CreativeLau/Mini-DSO/pic/IMG_6265.JPG

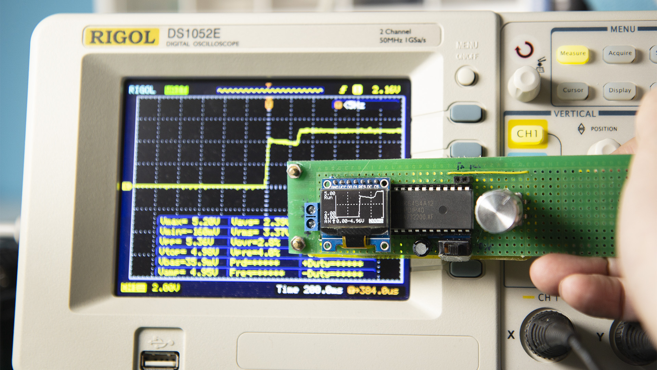
pic/IMG_6265.JPG
