CreativeLau/Mini-DSO/pic/IMG_6266.JPG

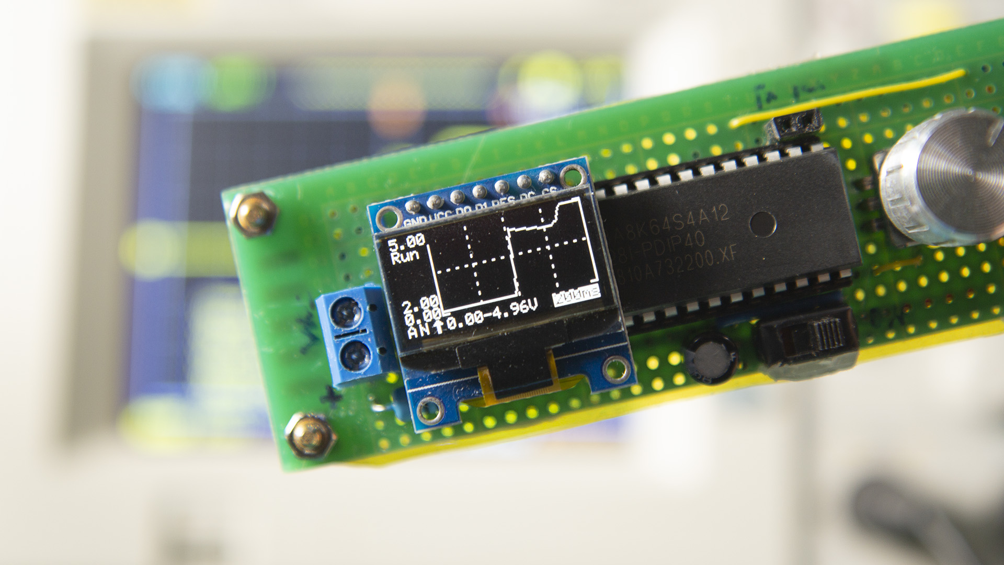
pic/IMG_6266.JPG
