CreativeLau/Mini-DSO/pic/IMG_6268.JPG

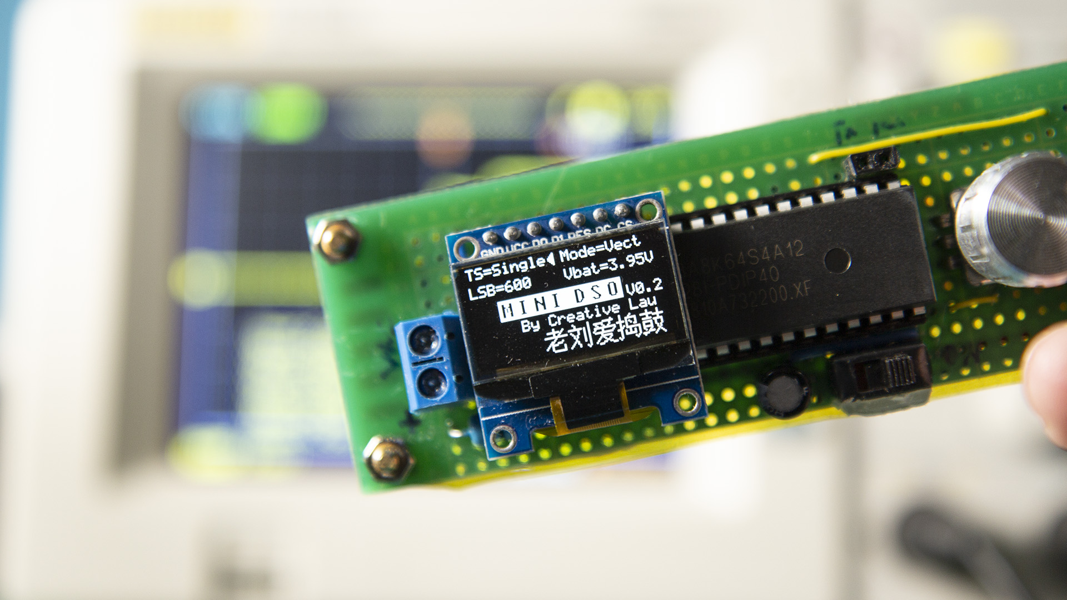
pic/IMG_6268.JPG
