CreativeLau/Mini-DSO/pic/IMG_6270.JPG

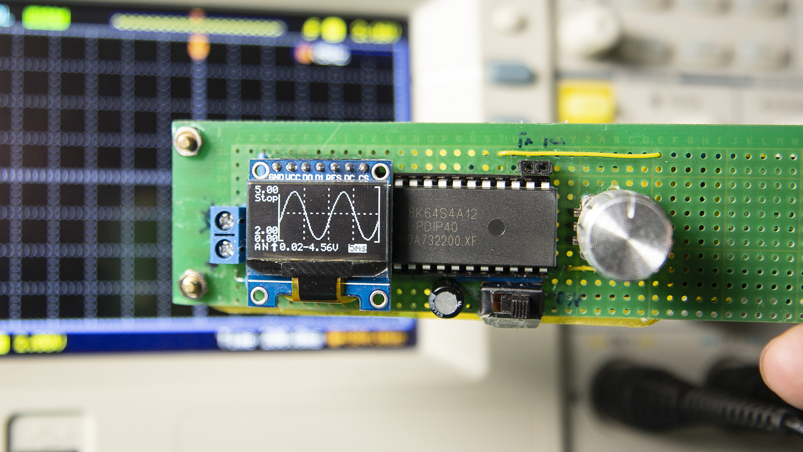
pic/IMG_6270.JPG
