CreativeLau/Mini-DSO/(threads)

Thread 1 (2020-05-19):

关于输入采样电路的疑问

jamwu, 2020-05-19:
老刘你好，我发现你设计的电路中，输入采样电路采用10k串上2k的电阻进行分压的。对此，我有点疑问，如下图：
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

CreativeLau, 2020-05-19:
单片机的ADC输入阻抗比较低，如果外部的分压输入阻抗太高的话会影响ADC的采样结果。你的这个电路，加上DSO后，R8和R9+R10等于是并联到一起，并联后的值是6K，6K和R7串在一起分压刚好是1/3。输入阻抗低的问题可以通过增加运放解决，但一般的运放在转换高频信号时速度跟不上。

jamwu, 2020-05-19:
> 单片机的ADC输入阻抗比较低，如果外部的分压输入阻抗太高的话会影响ADC的采样结果。你的这个电路，加上DSO后，R8和R9+R10等于是并联到一起，并联后的值是6K，6K和R7串在一起分压刚好是1/3。输入阻抗低的问题可以通过增加运放解决，但一般的运放在转换高频信号时速度跟不上。

懂了，我是没考虑到mcu的adc内部阻抗。那就是说按照目前的设计，只能用来测量等效电阻较小(<1k)的电路。否则误差就会比较大了是吧。另外，我觉得你这个挺有意思的，就按照你提供的资料，我自己也画 了个小板。不过还没焊接测试，下面附上3d图。测试没问题的话，会在这里提供项目的链接。
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

jamwu, 2020-05-27:
@CreativeLau 这里分享一下工程的链接-[Mini-DSO-PCB](https://oshwhub.com/jam_dan/mini_dso)

Thread 2 (2022-04-16):

限制这个示波器采样频率的瓶颈在哪里？

jamesbondjava, 2022-04-16:
小白一个，想请教一下，限制这个示波器采样频率不能过高的原因都有哪些？

ybhhdt, 2022-04-16:
您好，您的信息我已收到

ybhhdt, 2022-04-16:
主要是时钟频率吧，频率上限在哪里，而且处理数据也需要性能吧，了解得不太深入。

---原始邮件---
发件人: ***@***.***&gt;
发送时间: 2022年4月16日(周六) 下午5:16
收件人: ***@***.***&gt;;
抄送: ***@***.***&gt;;
主题: [CreativeLau/Mini-DSO] 限制这个示波器采样频率的瓶颈在哪里？ (Issue #2)

小白一个，想请教一下，限制这个示波器采样频率不能过高的原因都有哪些？

—
Reply to this email directly, view it on GitHub, or unsubscribe.
You are receiving this because you are subscribed to this thread.Message ID: ***@***.***&gt;

jamesbondjava, 2022-04-17:
@ybhhdt 非常感谢。那是否是：如果CPU的时钟频率、ADC的采样频率足够高，就可以了，对吗？

ddwtd, 2022-08-18:
不知道这个芯片能不能想stm32那样，用两个adc交叉采样一个通道来提高采样率

ybhhdt, 2022-08-18:
您好，您的信息我已收到

Thread 3 (2022-06-20):

一些计算细节的原理疑问？

HangX-Ma, 2022-06-20:
老刘你好，我在学习您的示波器代码的时候对以下几个计算公式感到了一些困惑，它们没有数学公式的说明，难以理解这样处理的缘由，希望您能给予解答。
- 问题1：在chart.c的AnalyseData()函数中，处理当前选择Option_MeaWay_AC方式进行测量的处理中，对DC输入您是用`Mvoltage_Aver += (VMax_m + VMin_m) >> 1`进行处理，但是AC部分却做了如下复杂计算，这个计算的依据是什么？
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

- 问题2：回头再看`VMax_m `和`VMin_m`，它们同样经过了一些处理，除此之外，它们是通过`adcMax-BiasVoltage`以及`adcMin-BiasVoltage`转换得到，`BiasVoltage`默认值为`8900`我原来猜测是4092满量程的偏移，但这个值还是让我感到困惑。
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

- 问题3：关于频率计算方面，您给了一个 $Waveform_{freq}=25000(ms)/(Range \times Interval)$ or $25000000(us)/(Range\times Interval)$ 的公式，`25000 or 25000000`这个基准值为什么这么选取？是与缓存大小相关吗？
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
```c
    switch (ScaleH)
    {
    case 0:                                      //500ms
        WaveFreq = 50.0f / (float)WaveLength + 0.5; //WaveFreq=25000/(500*WaveLength);
        break;

    case 1:                          //200ms
        WaveFreq = (125.0f / (float)WaveLength); //WaveFreq=25000/(200*WaveLength);
        break;

    case 2:                          //100ms
        WaveFreq = (250.0f / (float)WaveLength); //WaveFreq=25000/(100*WaveLength);
        break;

    case 3:                          //50ms
        WaveFreq = (500.0f / (float)WaveLength); //WaveFreq=25000/(50*WaveLength);
        break;

    case 4:                           //20ms
        WaveFreq = (1250.0f / (float)WaveLength); //WaveFreq=25000/(20*WaveLength);
        break;

    case 5:                           //10ms
        WaveFreq = (2500.0f / (float)WaveLength); //WaveFreq=25000/(10*WaveLength);
        break;

    case 6:                           //5ms
        WaveFreq = (5000.0f / (float)WaveLength); //WaveFreq=25000/(5*WaveLength);
        break;

    case 7:                            //2ms
        WaveFreq = (12500.0f / (float)WaveLength); //WaveFreq=25000/(2*WaveLength);
        break;

    case 8:                            //1ms
        WaveFreq = (25000.0f / (float)WaveLength); //WaveFreq=25000/(1*WaveLength);
        break;

    case 9:                            //500us
        WaveFreq = (50000.0f / (float)WaveLength); //WaveFreq=25000000/(500*WaveLength);
        break;

    case 10:                            //200us
        WaveFreq = (125000.0f / (float)WaveLength); //WaveFreq=25000000/(200*WaveLength);
        break;

    case 11:                            //100us
        WaveFreq = (250000.0f / (float)WaveLength); //WaveFreq=25000000/(100*WaveLength);
        break;
    }
```

- 问题4：在问题3中得到的$Waveform_{freq}$您又做了如下计算，这样做的目的以及依据是什么？
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
```c
WaveFreq = (float)WaveFreq /  (0.0162f * (log10(WaveFreq) /log10(2.7) ) + 0.9398f);
```
@CreativeLau 谢谢！

ybhhdt, 2022-06-20:
您好，您的信息我已收到
