CreativeLau/Mini-DSO/Ver.Frist/Mini DSO Scheme.pdf

# R3,R4用于电池电压采样，在关机状态下会消耗0.3mA左右的电流，如果介意则不要安装R3，R4

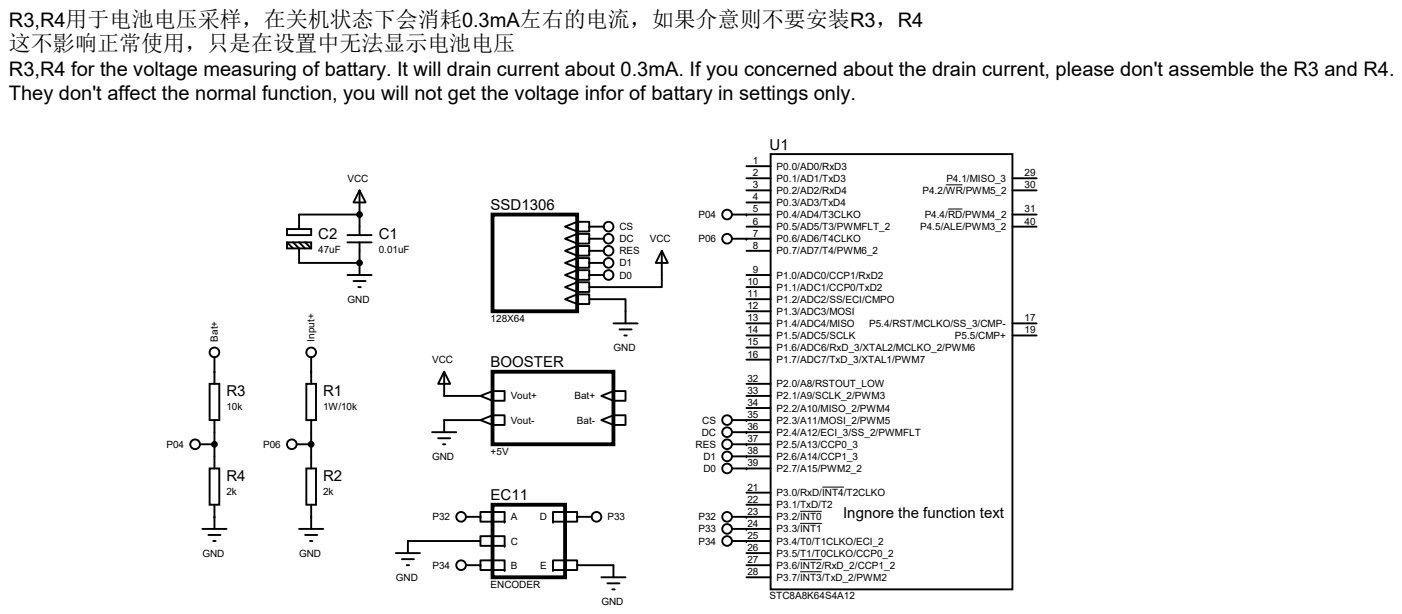
[picture p10: page 1]

这不影响正常使用，只是在设置中无法显示电池电压
R3,R4 for the voltage measuring of battary. It will drain current about 0.3mA. If you concerned about the drain current, please don't assemble the R3 and R4.
They don't affect the normal function, you will not get the voltage infor of battary in settings only.

Ingnore the function text
