CreativeLau/Mini-DSO/Ver.0.3/circuit_V0.3.pdf

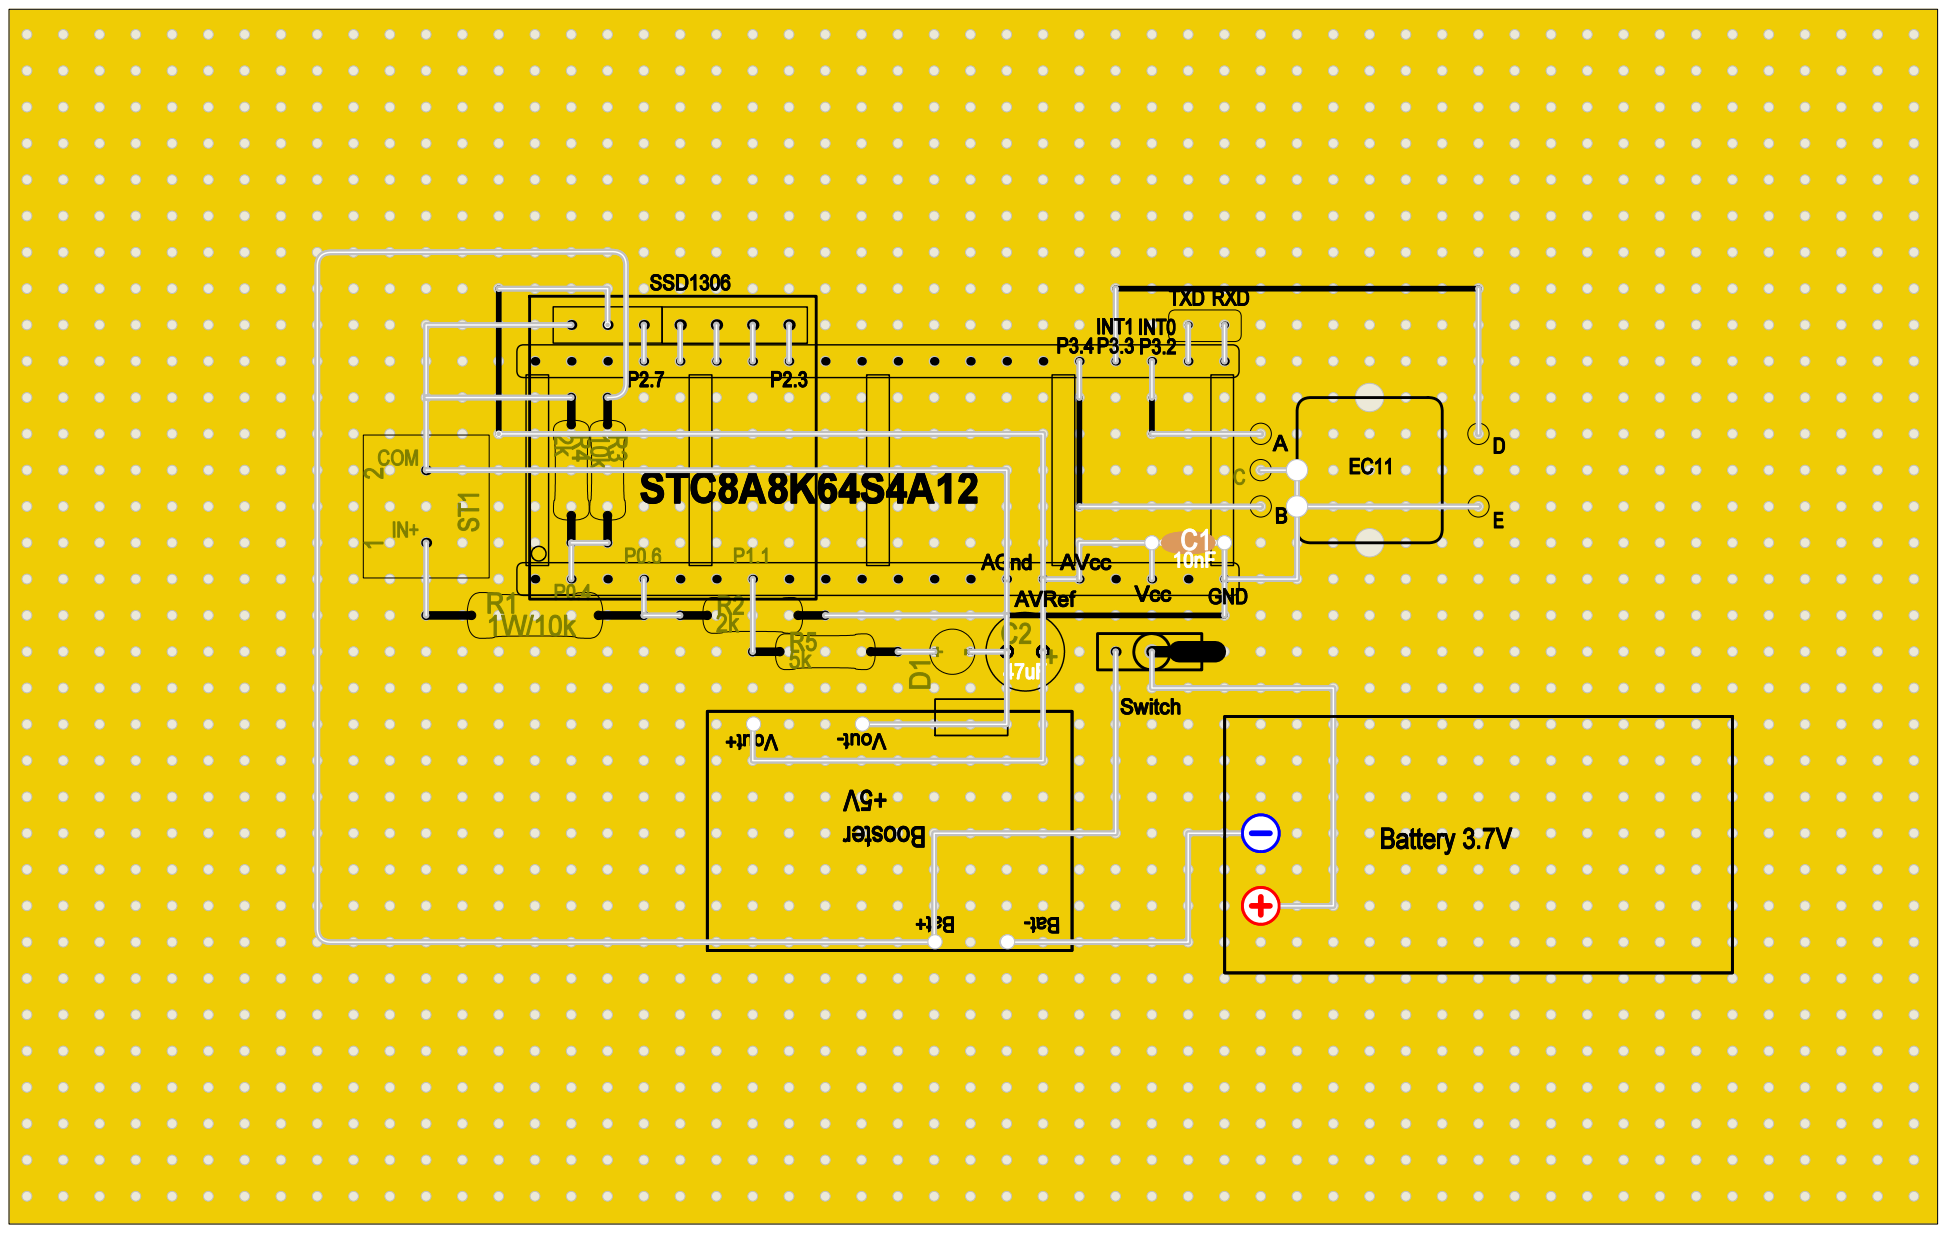
[picture p11: page 1]
