CreativeLau/Mini-DSO/Ver.0.3/Mini_DSO_Scheme_V0.3.pdf

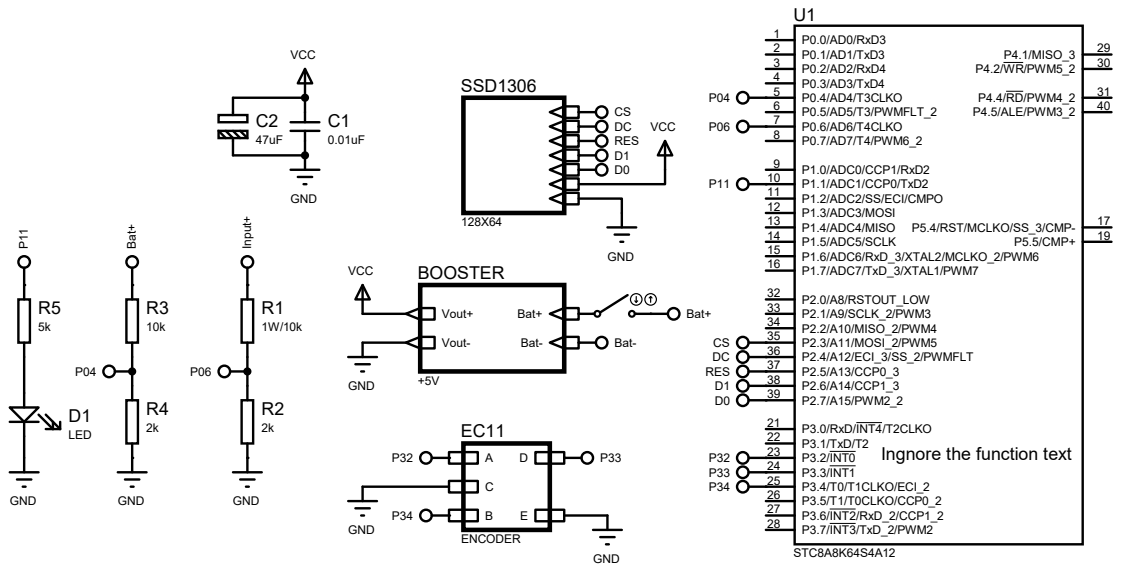
[picture p12: page 1]

Ingnore the function text
