CreativeLau/Mini-DSO/Ver.Frist/circuit1.pdf

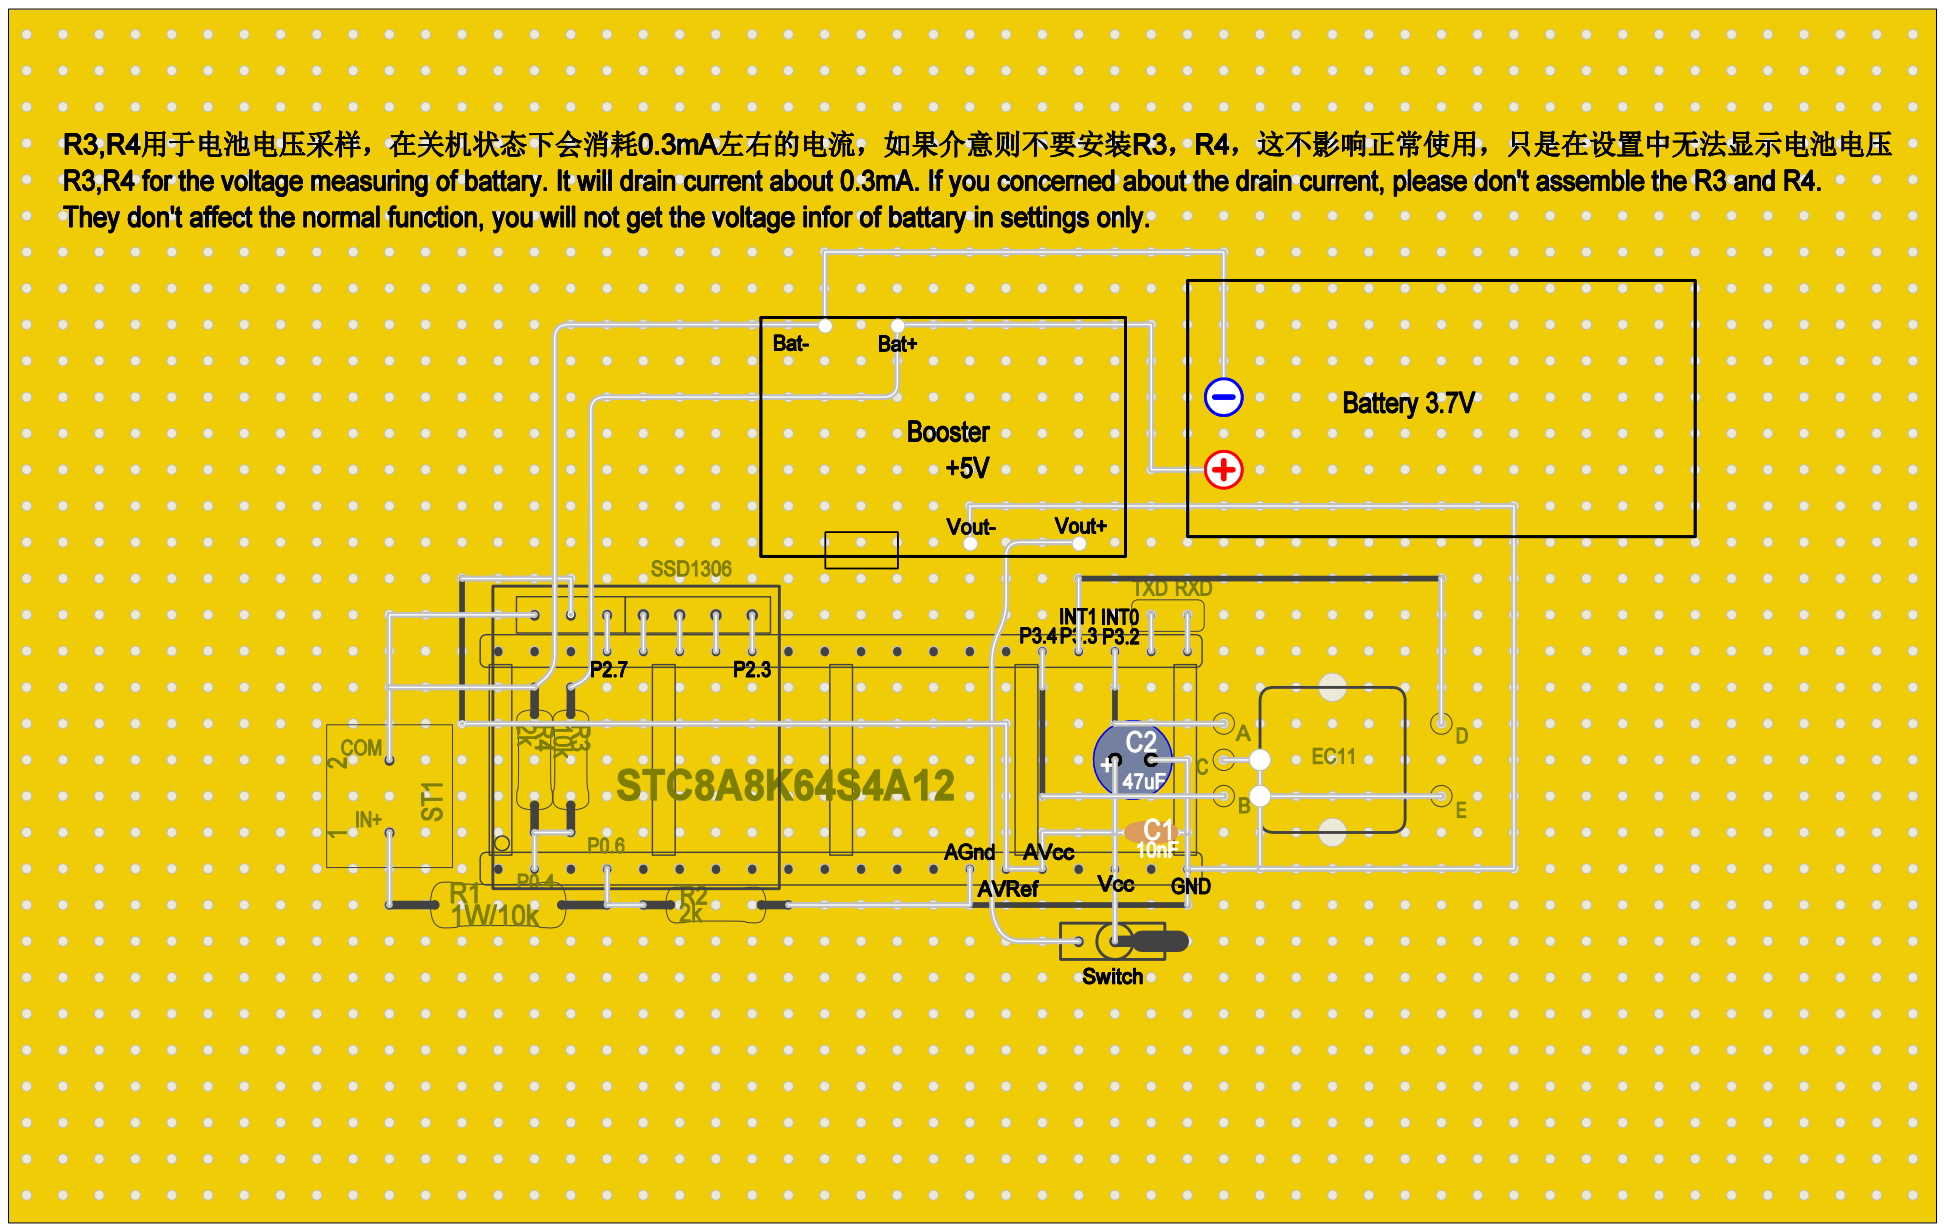
[picture p13: page 1]
