CreativeLau/Mini-DSO/Ver.Frist/circuit.pdf

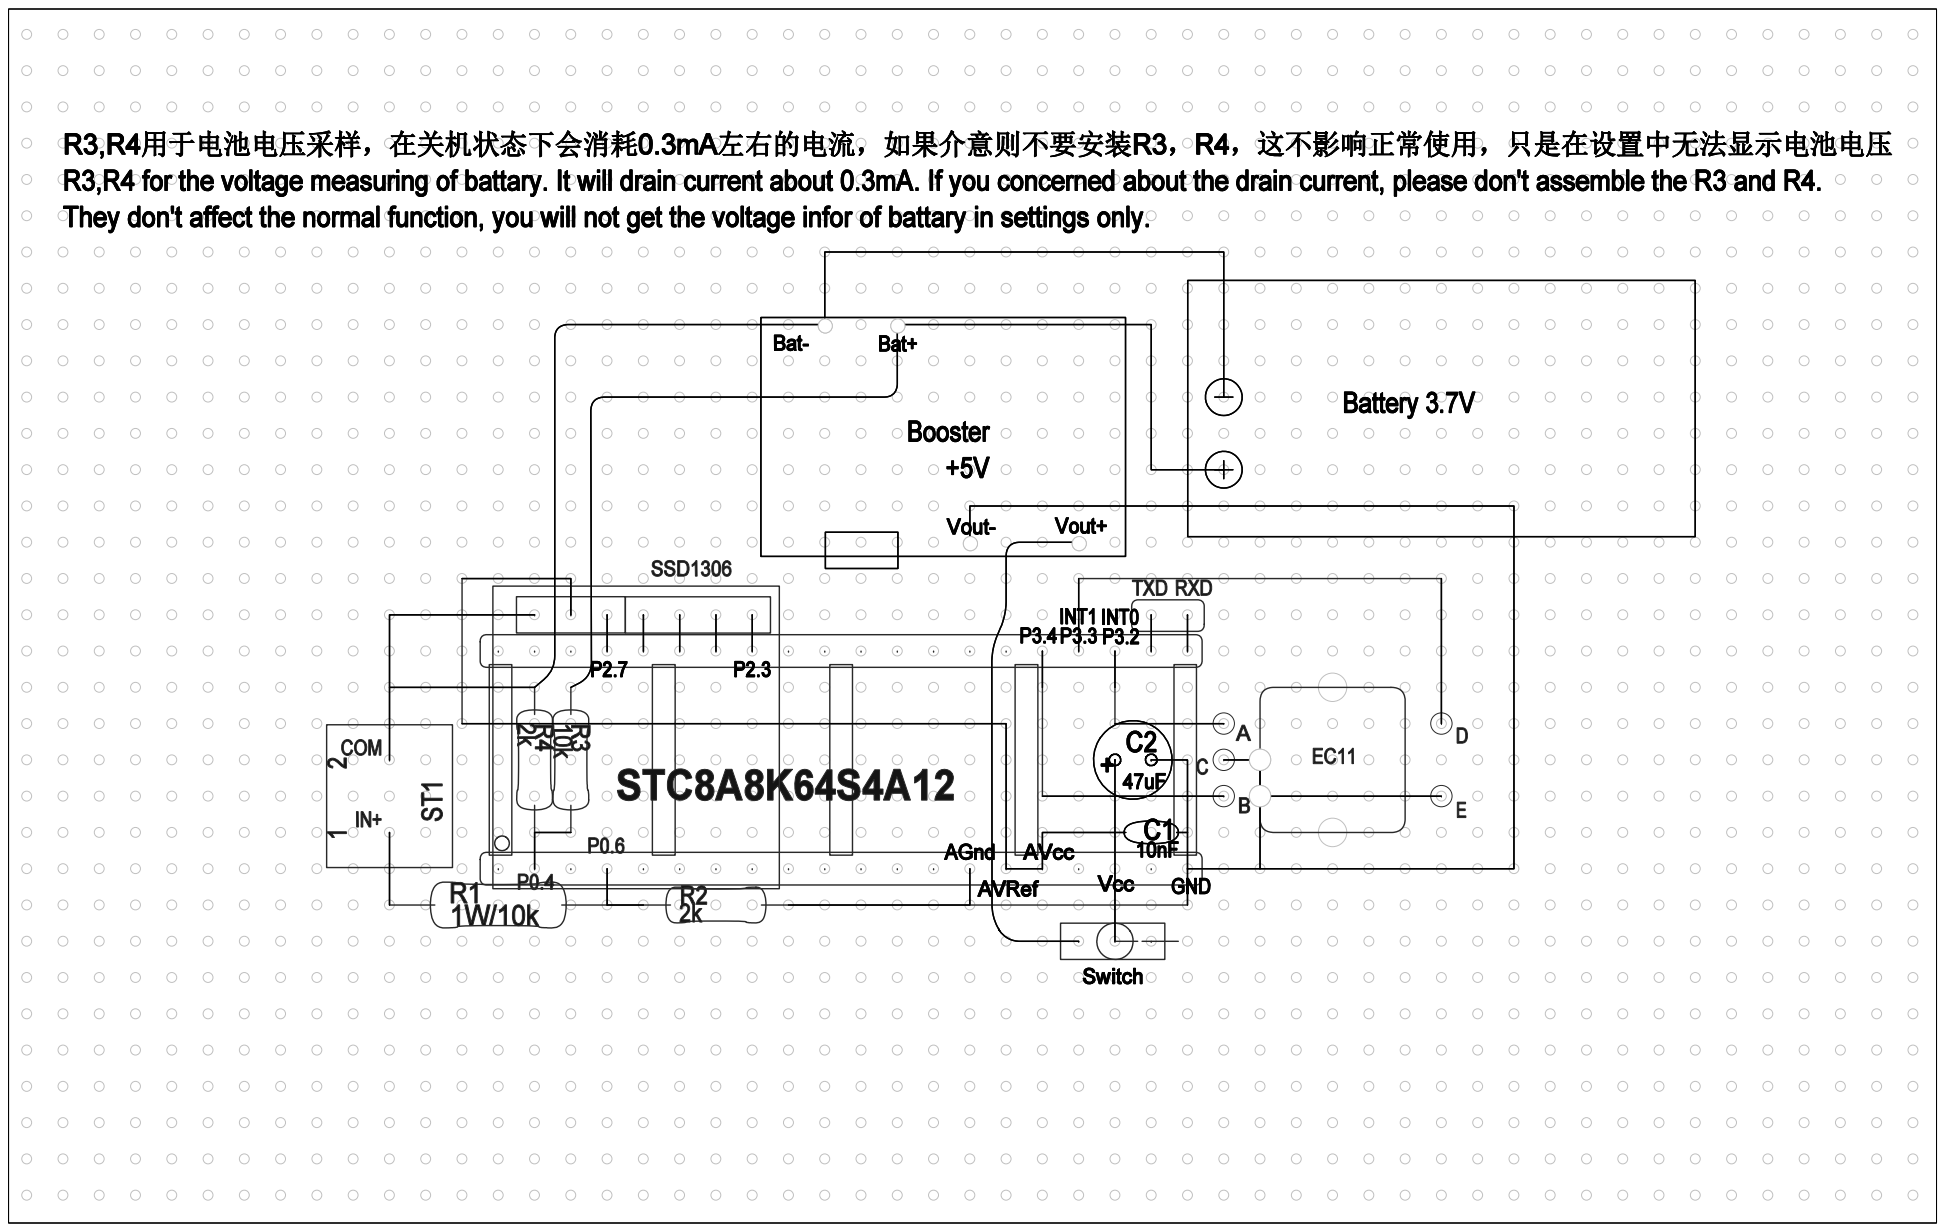
[picture p14: page 1]
