CreativeLau/Mini-DSO/(list of files, drawings)

Other design files:
Ver.0.3/Mini_DSO_Scheme_V0.3.pdsprj
Ver.Frist/Mini DSO Scheme.pdsprj
