CreativeLau/Mini-DSO/Ver.0.3/Code/bmp.h

#ifndef BMP_H
#define BMP_H

unsigned char code MINIDSO[]/*82x13*/ =
{
    0xFF, 0xFF, 0x03, 0x03, 0xEF, 0x1F, 0xEF, 0x03, 0x03, 0xFF, 0xFF, 0xFF, 0xFF, 0xFF, 0xFB, 0x03, 0x03, 0xFB, 0xFF, 0xFF, 0xFF, 0xFF, 0xFF, 0xFF, 0x03, 0x03, 0xCF, 0x9F, 0x3F, 0x03, 0x03, 0xFF, 0xFF, 0xFF, 0xFF, 0xFF, 0xFB, 0x03, 0x03, 0xFB, 0xFF,
    0xFF, 0xFF, 0xFF, 0xFF, 0xFF, 0xFF, 0xFF, 0xFF, 0xFF, 0xFF, 0x03, 0x03, 0xFB, 0xF3, 0x07, 0x0F, 0xFF, 0xFF, 0xFF, 0xFF, 0xFF, 0xE7, 0xC3, 0x9B, 0x3B, 0x73, 0xF7, 0xFF, 0xFF, 0xFF, 0xFF, 0xFF, 0x07, 0x03, 0xFB, 0xFB, 0x03, 0x07, 0xFF, 0xFF, 0xFF,
    0x1F, 0x1F, 0x18, 0x18, 0x1F, 0x1F, 0x1F, 0x18, 0x18, 0x1F, 0x1F, 0x1F, 0x1F, 0x1F, 0x1B, 0x18, 0x18, 0x1B, 0x1F, 0x1F, 0x1F, 0x1F, 0x1F, 0x1F, 0x18, 0x18, 0x1F, 0x1F, 0x1F, 0x18, 0x18, 0x1F, 0x1F, 0x1F, 0x1F, 0x1F, 0x1B, 0x18, 0x18, 0x1B, 0x1F,
    0x1F, 0x1F, 0x1F, 0x1F, 0x1F, 0x1F, 0x1F, 0x1F, 0x1F, 0x1F, 0x18, 0x18, 0x1B, 0x19, 0x1C, 0x1E, 0x1F, 0x1F, 0x1F, 0x1F, 0x1F, 0x1D, 0x19, 0x1B, 0x1B, 0x18, 0x1C, 0x1F, 0x1F, 0x1F, 0x1F, 0x1F, 0x1C, 0x18, 0x1B, 0x1B, 0x18, 0x1C, 0x1F, 0x1F, 0x1F,
};
#endif
