CreativeLau/Mini-DSO/(commit log)

2020-05-14 Archive Old Version
    [Mini DSO Scheme.pdsprj]
2020-05-14 Amend circuit
2020-05-16 🔥New Release
